Maxl94/Authentifizierung/Lock-à-dos.pptx

## Lock-à-dos

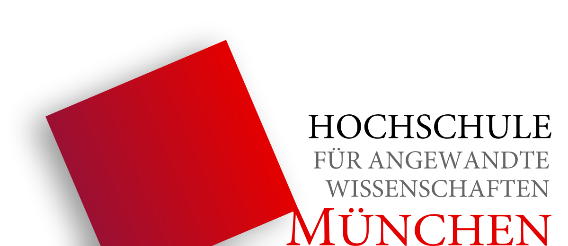
[picture p5: figure]
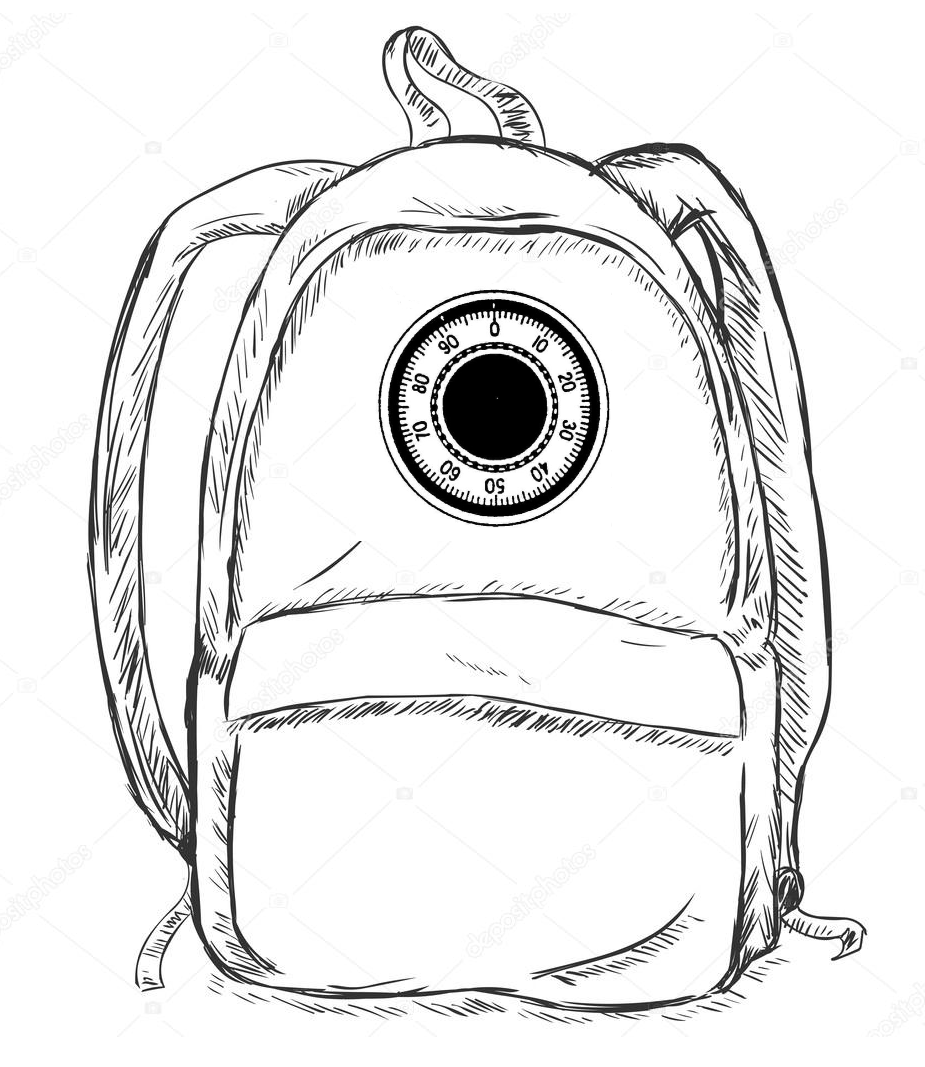
[picture p6: figure]

Ein Rucksack mit Selbstschutz

Lehrveranstaltung:
Authentifizierung im 21. Jh.
Dozent:
Prof. Dr. Florian Alt

Projektgruppe:
Balluff, Pachl, Schuhmann, Stadler
