Maxl94/Authentifizierung/paper/fig/thermal_img_static_dyn.pdf

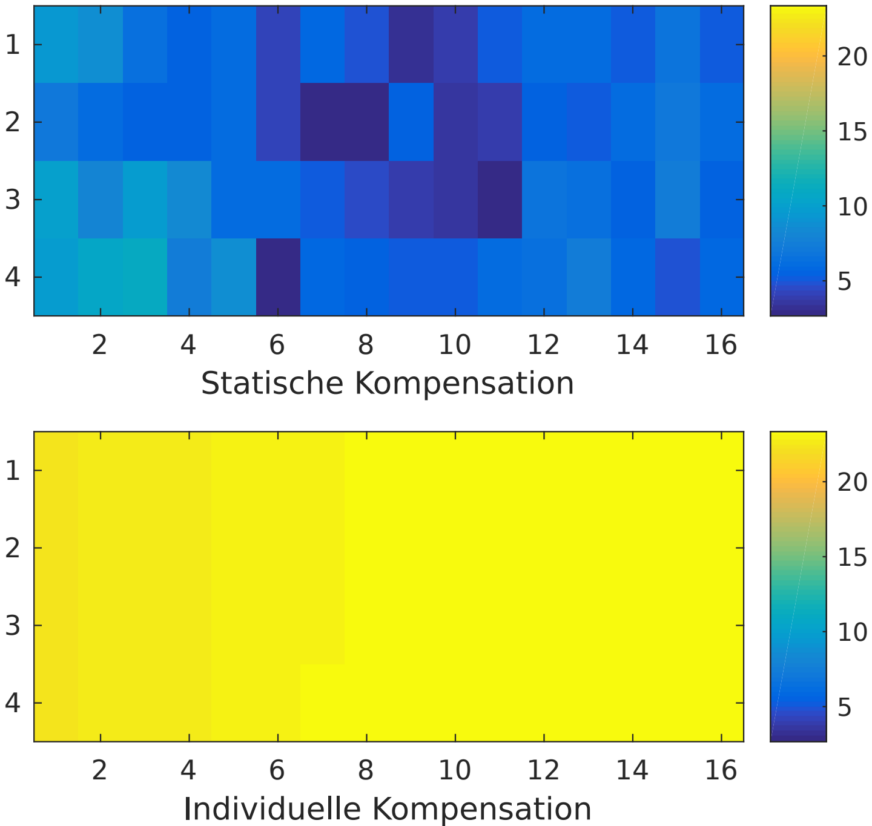
[picture p9: page 1]

2 | 4 | 6 | 8 | 10 | 12 | 14 | 16
Statische Kompensation

1

2

3

4 | 5
| 10

15

20

2 | 4 | 6 | 8 | 10 | 12 | 14 | 16
Individuelle Kompensation

1

2

3

4 | 5
| 10

15

20
