Maxl94/Authentifizierung/Screenshots/app_home.png

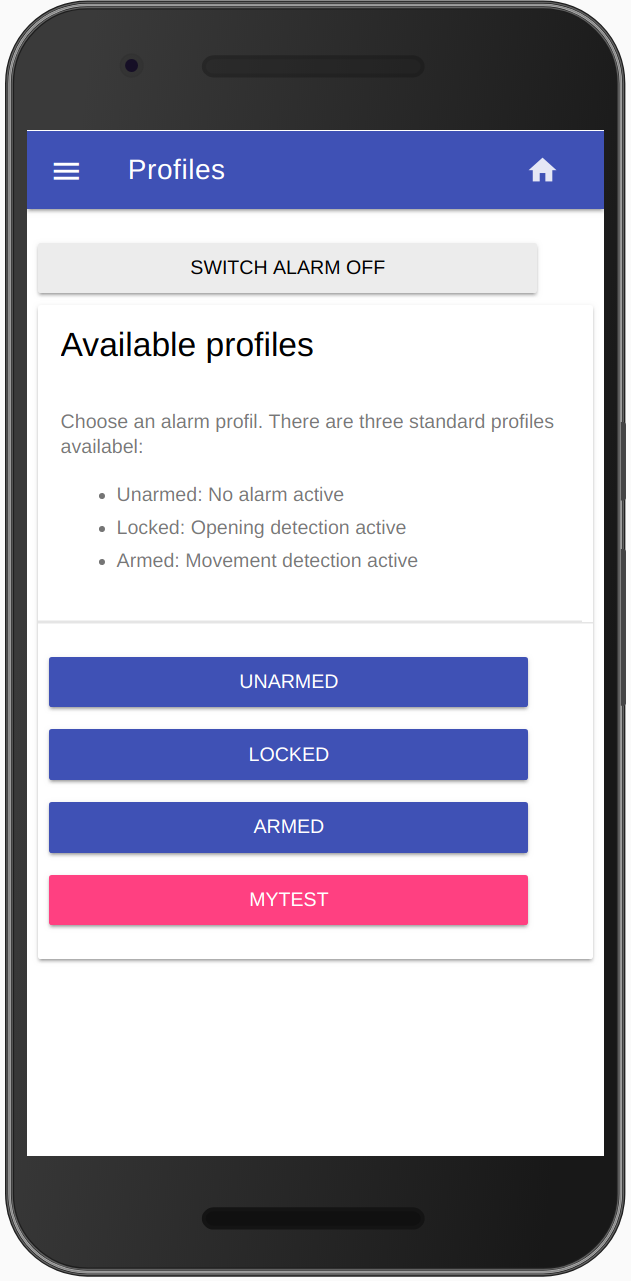
Screenshots/app_home.png
