Maxl94/Authentifizierung/Screenshots/app_profiles.png

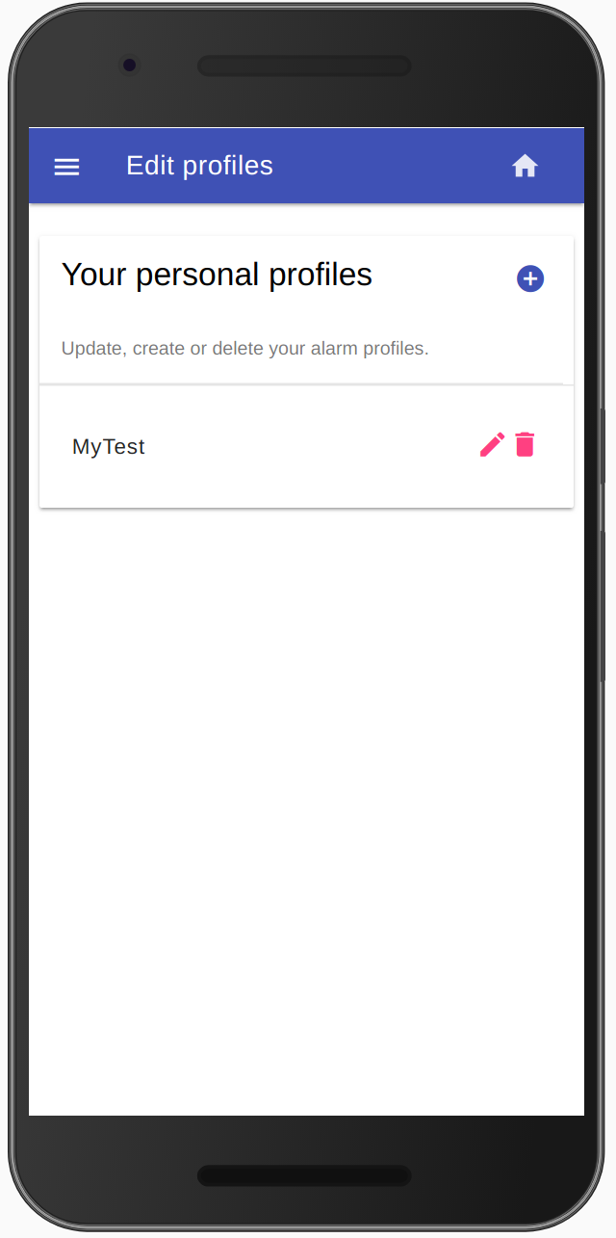
Screenshots/app_profiles.png
