Maxl94/Authentifizierung/Lock-a-dos Umfrage.xlsx

Timestamp | 1.1 Lassen Sie ihre Wertsachen (z.B. beim Baden am Strand) unbeaufsichtigt zurück? | 1.2 Würden Sie ihre Wertsachen (z.B. beim Baden am Strand) im schützenden Rucksack (Lock-à-dos) lassen? | 1.3 In welchen Situationen würden Sie sich zusätzlichen Schutz vor Taschendiebstahl wünschen? | 1.4 Wie sinnvoll finden sie diese Erweiterung (im Vergleich zu einem herkömmlichen Rucksack)? | 1.5 Wie viel wären sie bereit für das zusätzliche Feature zu zahlen (ohne Kosten für Rucksack)? | 1.6 Informieren Sie sich über neue elektronische Geräte, auch wenn Sie keine Kaufabsicht haben? | 2.1 Welchem Geschlecht gehören Sie an? | 2.2 Welcher Altersgruppe gehören Sie an?
2018-02-06 16:20 | Ja | Ja | Seminarraum, Als Tourist in anderen Städten | 4 | 20€ bis 40€ |  | männlich | 20 - 30
2018-02-06 19:12 | Ja, aber ich verstecke meine Wertsachen | Ja |  | 3 | 5€ bis 20€ |  | männlich | 20 - 30
2018-02-06 19:13 | Ja, aber ich verstecke meine Wertsachen | Vielleicht, kommt auf die Situation drauf an | Schloss | 4 | 5€ bis 20€ |  | weiblich | 20 - 30
2018-02-06 19:14 | Ja, aber ich verstecke meine Wertsachen | Ja | ÖPNV | 5 | 20€ bis 40€ |  | männlich | 30 -40
2018-02-06 19:14 | Nein | Vielleicht, kommt auf die Situation drauf an | In großen menschenmengen, auf reisen | 4 | 20€ bis 40€ |  | männlich | 20 - 30
2018-02-06 19:15 | Ja, aber ich verstecke meine Wertsachen | Ja |  | 3 | unter 5€ |  | männlich | unter 20 Jahre
2018-02-06 19:15 | Nein | Ja |  | 4 | 40€ bis 60€ |  | männlich | 20 - 30
2018-02-06 19:15 | Nein | Nein | Keine Ahnung würde noch nie beklaut | 5 | 60€ bis 80€ |  | männlich | 20 - 30
2018-02-06 19:20 | Ja, aber ich verstecke meine Wertsachen | Vielleicht, kommt auf die Situation drauf an | Bei großem Gedränge / großen Menschenmassen | 2 | 5€ bis 20€ |  | männlich | 20 - 30
2018-02-06 19:23 | Ja, aber ich verstecke meine Wertsachen | Ja | Festivals | 4 | 20€ bis 40€ |  | männlich | 20 - 30
2018-02-06 19:24 | Ja, aber ich verstecke meine Wertsachen | Vielleicht, kommt auf die Situation drauf an | Bei Reisen in fremde Länder oder Großstädten | 4 | 40€ bis 60€ |  | weiblich | 20 - 30
2018-02-06 19:26 | Nein | Nein |  | 3 | 5€ bis 20€ |  | männlich | 40 - 50
2018-02-06 19:30 | Ja, aber ich verstecke meine Wertsachen | Ja | Im Ausland, wo hohe Diebstahlsgefahr besteht | 4 | 20€ bis 40€ |  | weiblich | 20 - 30
2018-02-06 19:36 | Ja, aber ich verstecke meine Wertsachen | Ja | In einer großen Menschenmengw | 4 | 40€ bis 60€ |  | männlich | unter 20 Jahre
2018-02-06 19:37 | Ja, aber ich verstecke meine Wertsachen | Ja |  | 4 | 20€ bis 40€ |  | männlich | 20 - 30
2018-02-06 19:40 | Nein | Vielleicht, kommt auf die Situation drauf an |  | 3 | 20€ bis 40€ |  | männlich | 20 - 30
2018-02-06 19:45 | Ja | Ja | Sbahn fahren | 4 | 20€ bis 40€ |  | männlich | 20 - 30
2018-02-06 19:50 | Ja, aber ich verstecke meine Wertsachen | Vielleicht, kommt auf die Situation drauf an | Gedränge auf Straßen | 3 | 5€ bis 20€ |  | weiblich | 20 - 30
2018-02-06 19:53 | Ja, aber ich verstecke meine Wertsachen | Vielleicht, kommt auf die Situation drauf an | Konzerte, Großveranstaltungen | 4 | 20€ bis 40€ |  | männlich | 20 - 30
2018-02-06 20:14 | Nein | Vielleicht, kommt auf die Situation drauf an |  | 3 | 5€ bis 20€ |  | weiblich | 20 - 30
2018-02-06 20:15 | Ja, aber ich verstecke meine Wertsachen | Ja | Auf großen Veranstaltungen und im Urlaub. | 3 | 5€ bis 20€ |  | männlich | 40 - 50
2018-02-06 20:17 | Ja | Ja | Tourist in fremder Stadt | 5 | 20€ bis 40€ |  | männlich | 20 - 30
2018-02-06 20:24 | Ja, aber ich verstecke meine Wertsachen | Ja |  | 5 | 20€ bis 40€ |  | weiblich | 20 - 30
2018-02-06 21:40 | Ja | Ja | In der Bahn, In der Jugendherberge/Hostel | 4 | 40€ bis 60€ |  | männlich | 20 - 30
2018-02-06 21:57 | Ja | Ja |  | 3 | 40€ bis 60€ |  | männlich | 20 - 30
2018-02-06 22:06 | Ja, aber ich verstecke meine Wertsachen | Ja | Tourismusorte, Nachtleben | 4 | 20€ bis 40€ |  | männlich | 20 - 30
2018-02-06 23:44 | Ja, aber ich verstecke meine Wertsachen | Vielleicht, kommt auf die Situation drauf an |  | 4 | 5€ bis 20€ |  | männlich | 20 - 30
2018-02-07 00:09 | Ja, aber ich verstecke meine Wertsachen | Ja | Öffentliche Events wie Konzerte | 4 | unter 5€ |  | männlich | 20 - 30
2018-02-07 06:41 | Ja, aber ich verstecke meine Wertsachen | Ja | Öffentliche Verkehrsmittel | 5 | mehr als 80€ |  | weiblich | 20 - 30
2018-02-07 07:11 | Ja, aber ich verstecke meine Wertsachen | Ja | Im Ausland im Urlaub | 4 | 20€ bis 40€ |  | männlich | 20 - 30
2018-02-07 07:59 | Ja, aber ich verstecke meine Wertsachen | Ja | Ubahn | 5 | 20€ bis 40€ |  | männlich | 20 - 30
2018-02-07 21:44 | Nein | Nein |  | 3 | 40€ bis 60€ | Manchmal | männlich | 20 - 30
2018-02-08 08:54 | Ja | Ja |  | 4 | 20€ bis 40€ | Ja | männlich | 20 - 30
2018-02-09 16:30 | Ja | Ja |  | 4 | mehr als 80€ | Ja | männlich | 20 - 30
2018-02-09 16:39 | Nein | Vielleicht, kommt auf die Situation drauf an | Konzerte | 3 | 60€ bis 80€ | Ja | männlich | 20 - 30
2018-02-09 16:45 | Ja, aber ich verstecke meine Wertsachen | Ich weiß nicht ob das so viel bringt - wer was klauen will klaut auch den Rucksack. |  | 2 |  | Ja | weiblich | 20 - 30
2018-02-09 16:53 | Ja | Nein | Puffbesuch in Polen | 3 | 5€ bis 20€ | Ja | männlich | 20 - 30
2018-02-09 16:55 | Ja, aber ich verstecke meine Wertsachen | Vielleicht, kommt auf die Situation drauf an |  | 3 | 5€ bis 20€ | Ja | weiblich | 20 - 30
2018-02-09 16:57 | Ja, aber ich verstecke meine Wertsachen | Vielleicht, kommt auf die Situation drauf an | Reisen im Ausland | 3 | 5€ bis 20€ | Ja | männlich | 20 - 30
2018-02-09 17:02 | Nein | Vielleicht, kommt auf die Situation drauf an |  | 5 | 20€ bis 40€ | Manchmal | weiblich | 20 - 30
2018-02-09 17:05 | Ja, aber ich verstecke meine Wertsachen | Vielleicht, kommt auf die Situation drauf an | Wiesn, Tourismus-Spots im Ausland | 4 | 20€ bis 40€ | Ja | männlich | 30 -40
2018-02-09 17:19 | Ja, aber ich verstecke meine Wertsachen | Vielleicht, kommt auf die Situation drauf an | Beim weggehen | 5 | 5€ bis 20€ | Manchmal | weiblich | 20 - 30
2018-02-09 17:21 | Ja, aber ich verstecke meine Wertsachen | Vielleicht, kommt auf die Situation drauf an |  | 4 | 20€ bis 40€ | Manchmal | weiblich | 20 - 30
2018-02-09 17:39 | Ja, aber ich verstecke meine Wertsachen | Ja | In dichtem Gedränge der öffentlichen Verkehrsmittel o.a. | 5 | 20€ bis 40€ | Manchmal | weiblich | 50 - 60
2018-02-09 17:42 | Ja, aber ich verstecke meine Wertsachen | Ja | bei Benutzung von öffentlichen Verkehrsmitteln | 5 | 20€ bis 40€ | Manchmal | männlich | 50 - 60
2018-02-09 17:46 | Ja, aber ich verstecke meine Wertsachen | Vielleicht, kommt auf die Situation drauf an | In Bars und Kneipen | 4 | 20€ bis 40€ | Manchmal | männlich | 30 -40
2018-02-09 18:34 | Ja, aber ich verstecke meine Wertsachen | Vielleicht, kommt auf die Situation drauf an | Wenn in der Bib kein Spind mehr frei ist | 4 | 40€ bis 60€ | Ja | weiblich | 20 - 30
2018-02-09 18:59 | Ja, aber ich verstecke meine Wertsachen | Vielleicht, kommt auf die Situation drauf an |  | 2 | mehr als 80€ | Manchmal | männlich | 20 - 30
2018-02-09 19:05 | Nein | Vielleicht, kommt auf die Situation drauf an | In dichtem Gedränge | 3 | 20€ bis 40€ | Nein | weiblich | 20 - 30
2018-02-09 19:52 | Nein | Vielleicht, kommt auf die Situation drauf an | Beim Baden am See | 3 | unter 5€ | Manchmal | weiblich | 20 - 30
2018-02-09 20:59 | Ja, aber ich verstecke meine Wertsachen | Vielleicht, kommt auf die Situation drauf an | Feiern gehdn | 4 | 5€ bis 20€ | Ja | weiblich | 20 - 30
2018-02-09 21:17 | Ja, aber ich verstecke meine Wertsachen | Vielleicht, kommt auf die Situation drauf an | Weihnachtsmarkt | 4 | 20€ bis 40€ | Manchmal | weiblich | 20 - 30
2018-02-09 21:35 | Ja, aber ich verstecke meine Wertsachen | Ja |  | 2 | 5€ bis 20€ | Manchmal | weiblich | 20 - 30
2018-02-09 21:48 | Ja | Ja | In der S/U-Bahn | 2 | 20€ bis 40€ | Ja | männlich | 20 - 30
2018-02-09 22:19 | Ja, aber ich verstecke meine Wertsachen | Ja |  | 4 | 20€ bis 40€ | Nein | weiblich | 20 - 30
2018-02-09 23:37 | Ja, aber ich verstecke meine Wertsachen | Ja | Konzert | 3 | 60€ bis 80€ | Ja | männlich | 20 - 30
2018-02-10 03:11 | Ja, aber ich verstecke meine Wertsachen | Vielleicht, kommt auf die Situation drauf an | Großstadttrips | 4 | 20€ bis 40€ | Manchmal | weiblich | 20 - 30
2018-02-10 09:16 | Ja, aber ich verstecke meine Wertsachen | Vielleicht, kommt auf die Situation drauf an | Menschenmengen | 1 | unter 5€ | Nein | weiblich | 20 - 30
2018-02-10 09:21 | Ja | Ja | in Menschenmassen | 5 | 20€ bis 40€ | Nein | weiblich | 20 - 30
2018-02-10 10:37 | Ich nehme Wertsachen mit ins Wasser | Vielleicht, kommt auf die Situation drauf an | Reisen, Baden, in der Stadt ausgehen (aber Achtung, Rucksack soll schön und leicht sein. Viel Gewicht beim Reisen ist auch blöd, daher kein pacsafe!) | 4 | 20€ bis 40€ | Manchmal | weiblich | 20 - 30
2018-02-10 11:24 | Ja, aber ich verstecke meine Wertsachen | Ja | ubahn | 5 | 40€ bis 60€ | Ja | weiblich | 20 - 30
2018-02-10 12:43 | Ja, aber ich verstecke meine Wertsachen | Ja |  | 3 | unter 5€ | Manchmal | weiblich | 20 - 30
2018-02-10 12:48 | Ja, aber ich verstecke meine Wertsachen | Ja |  | 3 | 20€ bis 40€ | Ja | männlich | 20 - 30
2018-02-10 12:54 | Nein | Nein |  | 3 | 5€ bis 20€ | Manchmal | weiblich | 20 - 30
2018-02-10 13:55 | Ja, aber ich verstecke meine Wertsachen | Ja |  | 4 | 20€ bis 40€ | Manchmal | männlich | unter 20 Jahre
2018-02-10 15:28 | Ja, aber ich verstecke meine Wertsachen | Vielleicht, kommt auf die Situation drauf an | Enge Ubahnen und Plätze auf denen Personen dicht an dicht stehen | 2 | 5€ bis 20€ | Ja | weiblich | 20 - 30
2018-02-10 16:16 | Ja, aber ich verstecke meine Wertsachen | Ja | In großen Menschenmengen | 4 | 40€ bis 60€ | Ja | männlich | 20 - 30
2018-02-10 22:35 | Ja, aber ich verstecke meine Wertsachen | Ja |  | 5 | 20€ bis 40€ | Manchmal | weiblich | 20 - 30
2018-02-11 00:07 | Ja, aber ich verstecke meine Wertsachen | Ja | Auf der Straße, in Menschenmengen | 5 | 5€ bis 20€ | Nein | weiblich | 20 - 30
2018-02-11 11:09 | Ja, aber ich verstecke meine Wertsachen | Vielleicht, kommt auf die Situation drauf an |  | 3 | 5€ bis 20€ | Manchmal | weiblich | 20 - 30
2018-02-11 12:45 | Nur wenn ich alleine am Badesee in der Heimat bin. | Vielleicht, kommt auf die Situation drauf an | In keiner. Ich trage meine Wertsachen bei mir. | 1 | unter 5€ | Ja | weiblich | 20 - 30
2018-02-11 21:40 | Nein | Vielleicht, kommt auf die Situation drauf an | In der Stadt und im Urlaub, wenn viele Leute an einem bestimmten Platz, Museum o.Ä. unterwegs sind. | 4 | 5€ bis 20€ | Manchmal | weiblich | unter 20 Jahre
2018-02-11 22:56 | Ja, aber ich verstecke meine Wertsachen | Vielleicht, kommt auf die Situation drauf an | In manchen Großstädten, bei Veranstaltungen | 4 | 5€ bis 20€ | Manchmal | weiblich | 20 - 30
2018-02-12 10:42 | Nein | Vielleicht, kommt auf die Situation drauf an |  | 4 | 5€ bis 20€ | Manchmal | weiblich | 20 - 30
2018-02-12 11:04 | habe kaum welche dabei | Nein | Großveranstaltungen, Festivals, Partys, Baden am See und Schwimmbad | 2 | 5€ bis 20€ | Nein | männlich | 20 - 30
2018-02-12 16:08 | Ja, aber ich verstecke meine Wertsachen | Ja |  | 4 | 5€ bis 20€ | Manchmal | weiblich | 20 - 30
