Maxl94/Authentifizierung/PCB/LDR_MLX.kicad_pcb

## KiCad design PCB/LDR_MLX.kicad_pcb (2018-02-05)

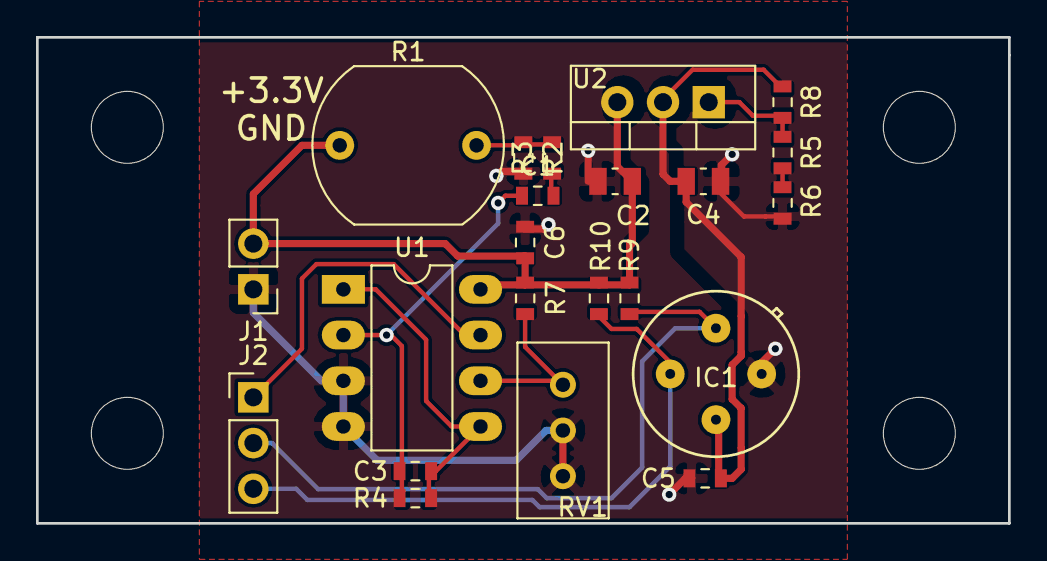
[picture p12: board LDR_MLX.kicad_pcb from above]

Board: 2 copper layers, 54.0 x 27.0 mm, 22 parts (0 on the bottom side), 13 nets.

Parts:
C1, C5, C6: 100n; C_0603_1608Metric
C2, C4: 1u; C_0805_2012Metric
C3: 100p; C_0603_1608Metric
IC1: MLX90621
J1: Conn_01x02; PinHeader_1x02_P2.54mm_Vertical
J2: Conn_01x03; PinHeader_1x03_P2.54mm_Vertical
R1: R_PHOTO; Resistor_LDR_10x8.5_RM7.6
R2: 10k; R_0603_1608Metric
R3: 1k; R_0603_1608Metric
R4, R7: 100k; R_0603_1608Metric
R5: Behelfswiderstand; R_0603_1608Metric
R6: 130, 390, 510; R_0603_1608Metric
R8: 120, 360, 470; R_0603_1608Metric
R9, R10: 4,7k; R_0603_1608Metric
RV1: 1k; Potentiometer_Bourns_3296W_Vertical
U1: LM2904; DIP-8_W7.62mm_LongPads
U2: LM317_3PinPackage; TO-220-3_Vertical

Connections:
+3V3: C2.2, C6.2, J1.2, R1.1, R7.2, R9.2, R10.2, U1.8, U2.3
/+2.6V: C4.2, C5.2, IC1.3, R8.2, U2.2
/I2C_SCL: IC1.1, J2.2, R9.1
/I2C_SDA: IC1.2, J2.3, R10.1
/LIGHT_DET: J2.1, U1.7
GND: C2.1, C4.1, C5.1, C6.1, IC1.4, J1.1, R2.2, R6.1, RV1.2, RV1.3, U1.3, U1.4
unnamed: C1.1, C3.2, R4.2, U1.2
unnamed: C1.2, R3.1
unnamed: C3.1, R4.1, U1.1, U1.5
unnamed: R1.2, R2.1, R3.2
unnamed: R5.1, R6.2
unnamed: R5.2, R8.1, U2.1
unnamed: R7.1, RV1.1, U1.6
