Maxl94/Authentifizierung/(commit log)

2018-01-10 Ansteuerung GPS Modul per UART
2018-01-10 Webserver Addes Update, Create, Delete Mode, Bugfiexes Modes
    [models.py, urls.py, views.py]
2018-01-10 Added button for stopping alarm, small bugfiex in views
    [urls.py, views.py]
2018-01-15 Thermosensor und Auswertung hinzugefügt, IP Addr geg. anpassen
2018-01-16 Addes Michis Zeug und Videos
2018-01-16 chore: remove unused sensors
2018-01-16 Added: BNO055 9dof sensor
2018-01-16 feat: add gyro connection
2018-01-16 fix: spaces and tabs mixed
    [bno.py]
2018-01-16 fix: using same variable names as django for sensors
2018-01-16 fix: add better print comment
2018-01-16 feat: add light sensor
2018-01-16 Added start sensors ond start server
2018-01-16 Bugfix switch (hoffentlich)
2018-01-16 Bugfis switches
2018-01-16 Repaces switch with checkbox
2018-01-16 feat: add ir sensoric
2018-01-21 Text: IR Sensor hinzugefügt
2018-01-21 IR Sensor falsche Datei hinzugefügt
2018-01-23 Schnellerer Abfragezyklus der Sensoren
2018-01-23 Added savezones, bugfixes profiles
    [models.py, urls.py, views.py]
2018-02-03 Bugfixes Server, added dummy for savezones, fix database
    [views.py, wsgi.py]
2018-02-03 Bugfix ir sensor
2018-02-03 Removed print
2018-02-03 Added Current Location to update
2018-02-03 Removed "Current Location" Entry from overview
2018-02-03 Button left
2018-02-03 Kleinere Aenderungen, Alarm geht automatisch aus wenn Profil gewechselt wird, Datenbank default angepasst
2018-02-05 Platine hinzugefügt
    [LDR_MLX-B.Cu.gbr, LDR_MLX-B.Mask.gbr, LDR_MLX-B.SilkS.gbr, LDR_MLX-Edge.Cuts.gbr, LDR_MLX-F.Cu.gbr, LDR_MLX-F.Mask.gbr, LDR_MLX-F.SilkS.gbr, LDR_MLX-NPTH.drl]
2018-02-05 BNO Werte angepasst, Motion Detection History Background angepasst und Request pro Zeit verringert
2018-02-05 Captive Portal Funktion hinzugefügt: Alle Request ohne bekannte URL werden nun per 302 auf die Loginseite weitergeleitet. Problem ist das die URL RegExe alle mit / enden (z.B. settings/create/) aber 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
    [urls.py, views.py]
2018-02-05 Added LED and alarmstop
2018-02-18 Umfragenergebnisse hinzugefügt
    [Lock-a-dos Umfrage.xlsx]
